movuino/OpenHealthBand/hardware/Shields/MovuinoHealthBandV0.2.7.2-max86141-v0.2.2-panel.brd

## EAGLE design hardware/Shields/MovuinoHealthBandV0.2.7.2-max86141-v0.2.2-panel.brd (2021-08-28)

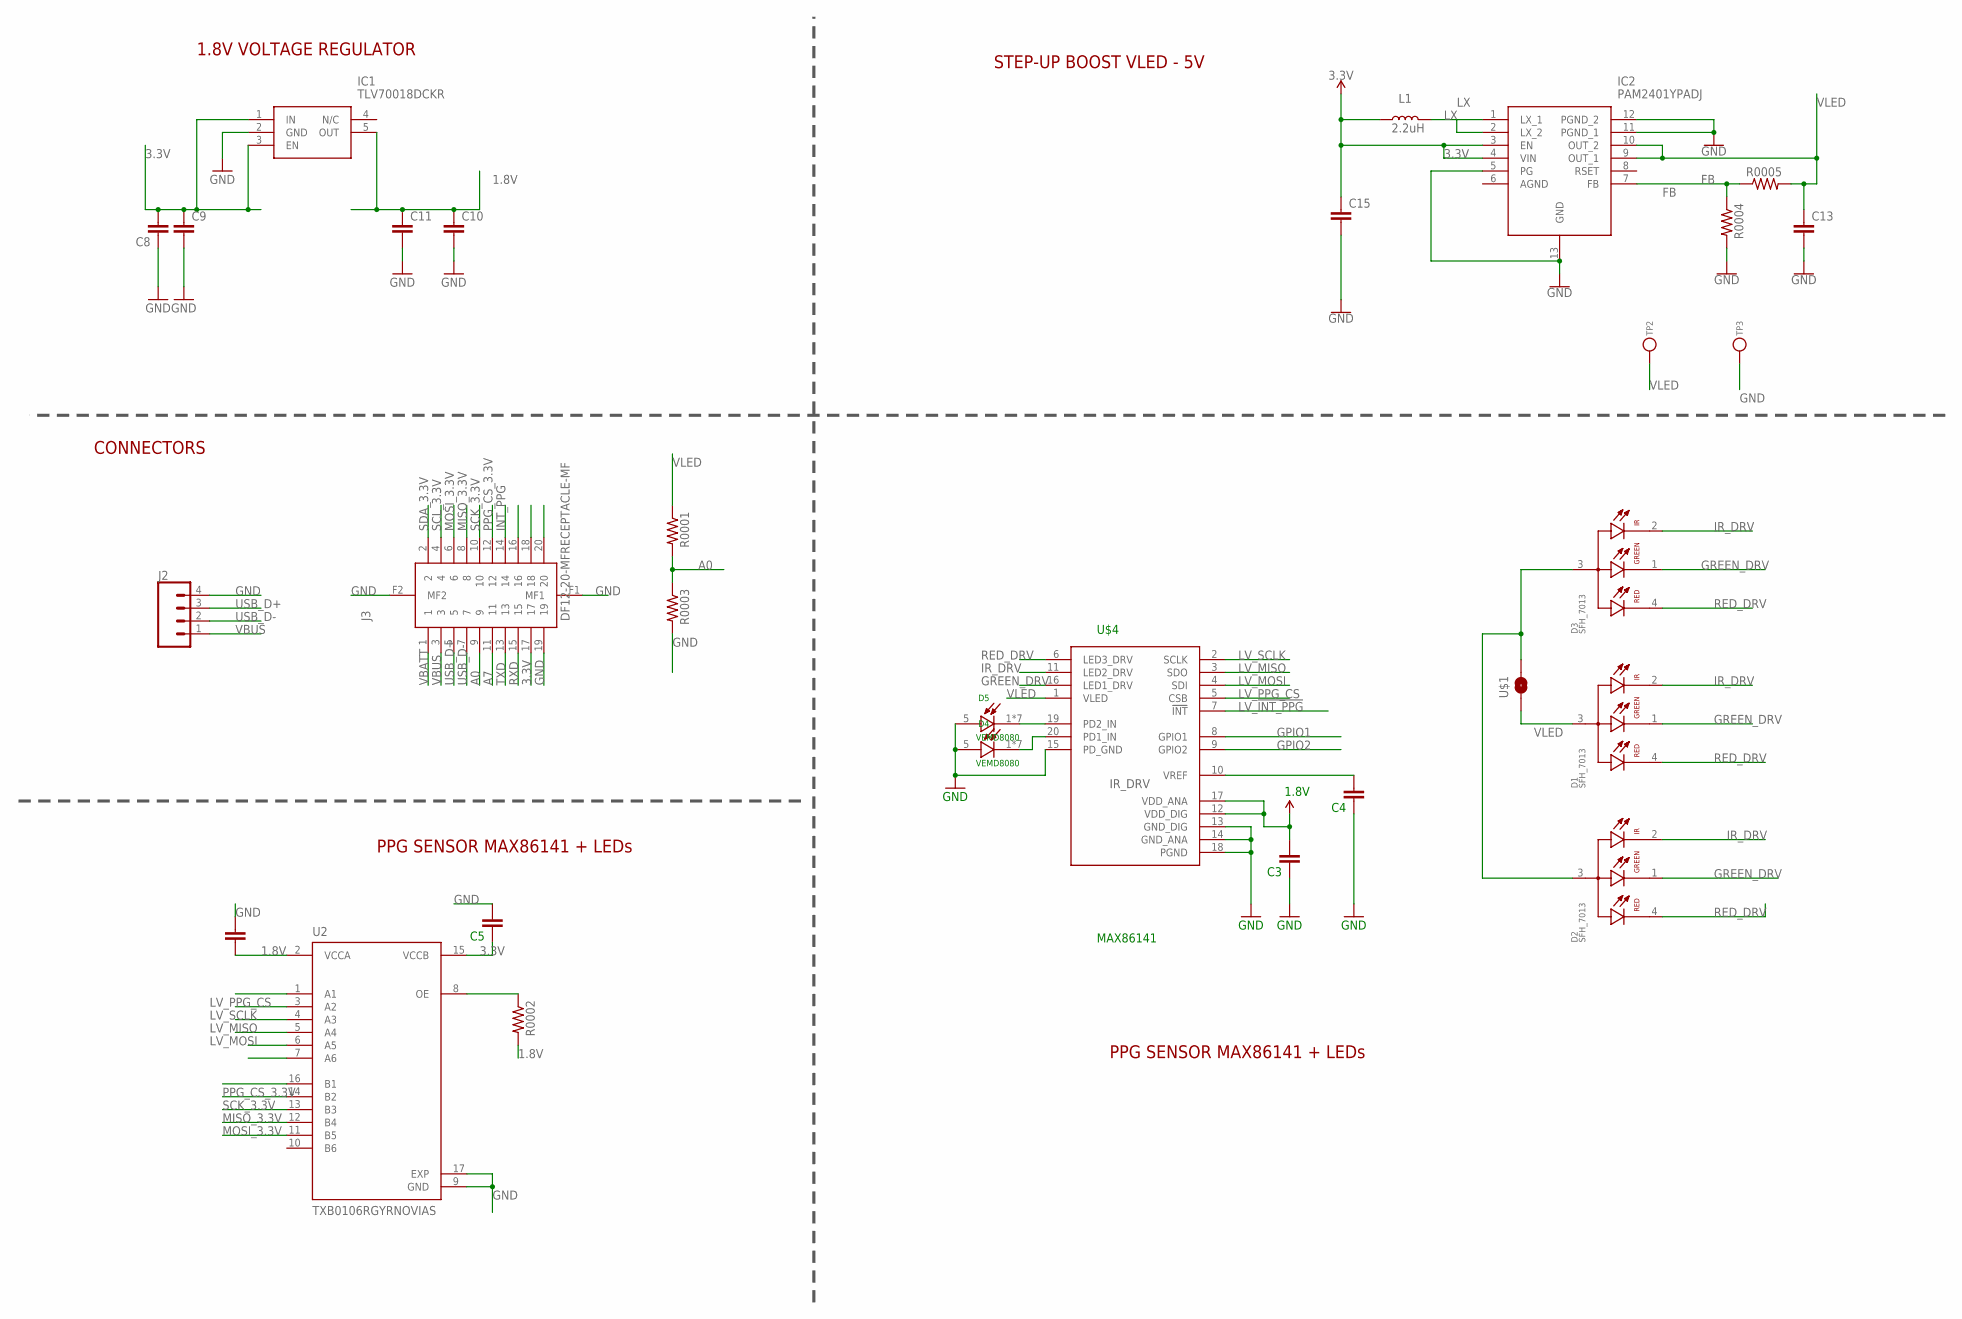
[picture p5: schematic MovuinoHealthBandV0.2.7.2-max86141-v0.2.2-panel.sch]

Parts:
C3: 1uF; 0402-CAP
C4: 10uF; 0402-CAP
C5, C6: 0.1uF; 0402-CAP
C8, C15: 10uF; 0402-CAP-SMALL-TDOCU
C9, C10: 0.1uF; 0402-CAP-SMALL-TDOCU
C11: 4.7uF; 0402-CAP-SMALL-TDOCU
C13: 22uF; 0402-CAP-SMALL-TDOCU
D1, D2, D3: SFH_7013
D4, D5: VEMD8080; XDCR_VEMD8080
IC1: TLV70018DCKR; SOT65P210X110-5N
IC2: PAM2401YPADJ; SON45P295X295X60-13N
J2: CONN_04POGO-2.54; POGO_2.54_X4
J3: DF12-20-MFRECEPTACLE-MF; DF12-20-DS
L1: 2.2uH; INDC2016X100N
R0001, R0002, R0003, R0004: 100K; 0402-RES
R0005: 750K; 0402-RES
TP2, TP3: TESTPOINT1MM-ROUND-CREAM; TESTPOINT_ROUND_1MM-CREAM
U2: TXB0106RGYRNOVIAS; QFN50P400X350X100-17N-2
U$1: 0402-JUMPER
U$4: MAX86141; 20_PIN_WLP

Connections:
1.8V: C3.2, C6.1, C10.1, C11.1, IC1.5 (OUT), R0002.2, U2.2 (VCCA), U$4.12 (VDD_DIG), U$4.17 (VDD_ANA)
3.3V: C5.1, C8.2, C9.1, C15.1, IC1.1 (IN), IC1.3 (EN), IC2.3 (EN), IC2.4 (VIN), J3.17, L1.1, U2.15 (VCCB)
A0: J3.9, R0001.2, R0003.1
A7: J3.11
FB: IC2.7 (FB), R0004.1, R0005.1
GND: C3.1, C4.1, C5.2, C6.2, C8.1, C9.2, C10.2, C11.2, C13.2, C15.2, D4.5 (A), D5.5 (A), IC1.2 (GND), IC2.5 (PG), IC2.11 (PGND_1), IC2.12 (PGND_2), IC2.13 (GND), J2.4, J3.19, J3.F1 (MF1), J3.F2 (MF2), R0003.2, R0004.2, TP3.P$1, U2.9 (GND), U2.17 (EXP), U$4.13 (GND_DIG), U$4.14 (GND_ANA), U$4.15 (PD_GND), U$4.18 (PGND)
GPIO1: U$4.8 (GPIO1)
GPIO2: U$4.9 (GPIO2)
GREEN_DRV: D1.1 (CATHODE_EMITTER_2), D2.1 (CATHODE_EMITTER_2), D3.1 (CATHODE_EMITTER_2), U$4.16 (LED1_DRV)
INT_PPG: J3.14
IR_DRV: D1.2 (CATHODE_EMITTER_3), D2.2 (CATHODE_EMITTER_3), D3.2 (CATHODE_EMITTER_3), U$4.11 (LED2_DRV)
LV_!INT_PPG!: U$4.7 (!INT!)
LV_MISO: U2.5 (A4), U$4.3 (SDO)
LV_MOSI: U2.6 (A5), U$4.4 (SDI)
LV_PPG_CS: U2.3 (A2), U$4.5 (CSB)
LV_SCLK: U2.4 (A3), U$4.2 (SCLK)
LX: IC2.1 (LX_1), IC2.2 (LX_2), L1.2
MISO_3.3V: J3.8, U2.12 (B4)
MOSI_3.3V: J3.6, U2.11 (B5)
unnamed: R0002.1, U2.8 (OE)
unnamed: C4.2, U$4.10 (VREF)
unnamed: D5.1 (C), D5.2 (C), D5.3 (C), D5.4 (C), D5.6 (C), D5.7 (C), D5.8 (C), U$4.19 (PD2_IN)
unnamed: D4.1 (C), D4.2 (C), D4.3 (C), D4.4 (C), D4.6 (C), D4.7 (C), D4.8 (C), U$4.20 (PD1_IN)
unnamed: D2.3 (ANODE_EMITTER_1/2/3), D3.3 (ANODE_EMITTER_1/2/3), U$1.2
PPG_CS_3.3V: J3.12, U2.14 (B2)
RED_DRV: D1.4 (CATHODE_EMITTER_1), D2.4 (CATHODE_EMITTER_1), D3.4 (CATHODE_EMITTER_1), U$4.6 (LED3_DRV)
RXD: J3.15
SCK_3.3V: J3.10, U2.13 (B3)
SCL_3.3V: J3.4
SDA_3.3V: J3.2
TXD: J3.13
USB_D+: J2.3, J3.5
USB_D-: J2.2, J3.7
VBATT: J3.1
VBUS: J2.1, J3.3
VLED: C13.1, D1.3 (ANODE_EMITTER_1/2/3), IC2.9 (OUT_1), IC2.10 (OUT_2), R0001.1, R0005.2, TP2.P$1, U$1.1, U$4.1 (VLED)

Notes on the sheet:
PPG SENSOR MAX86141 + LEDs
STEP-UP BOOST VLED - 5V
1.8V VOLTAGE REGULATOR
CONNECTORS

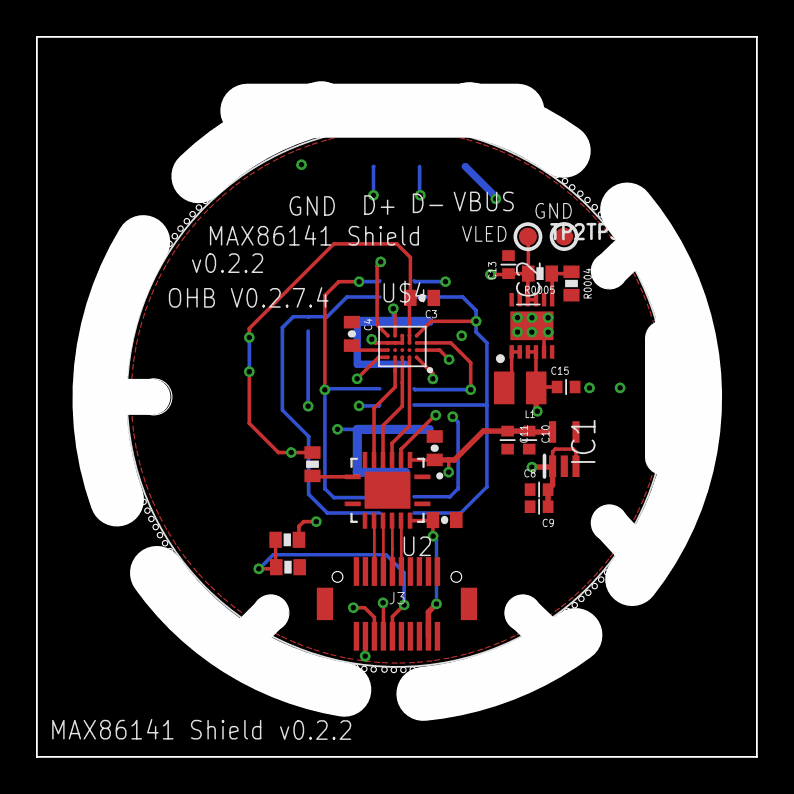
[picture p6: board MovuinoHealthBandV0.2.7.2-max86141-v0.2.2-panel.brd from above]

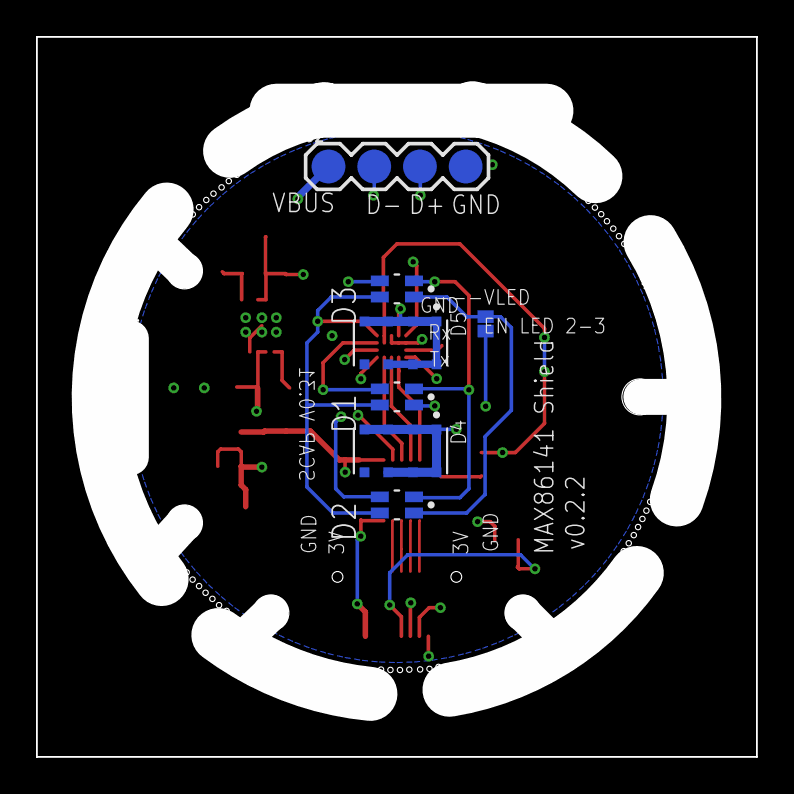
[picture p7: board MovuinoHealthBandV0.2.7.2-max86141-v0.2.2-panel.brd from below]

Board: 4 copper layers, 40.0 x 40.0 mm, 30 parts (7 on the bottom side), 26 nets.
