movuino/OpenHealthBand/hardware/PPGShieldSmall-V0.2-EC.brd

## EAGLE design hardware/PPGShieldSmall-V0.2-EC.brd (2020-03-24)

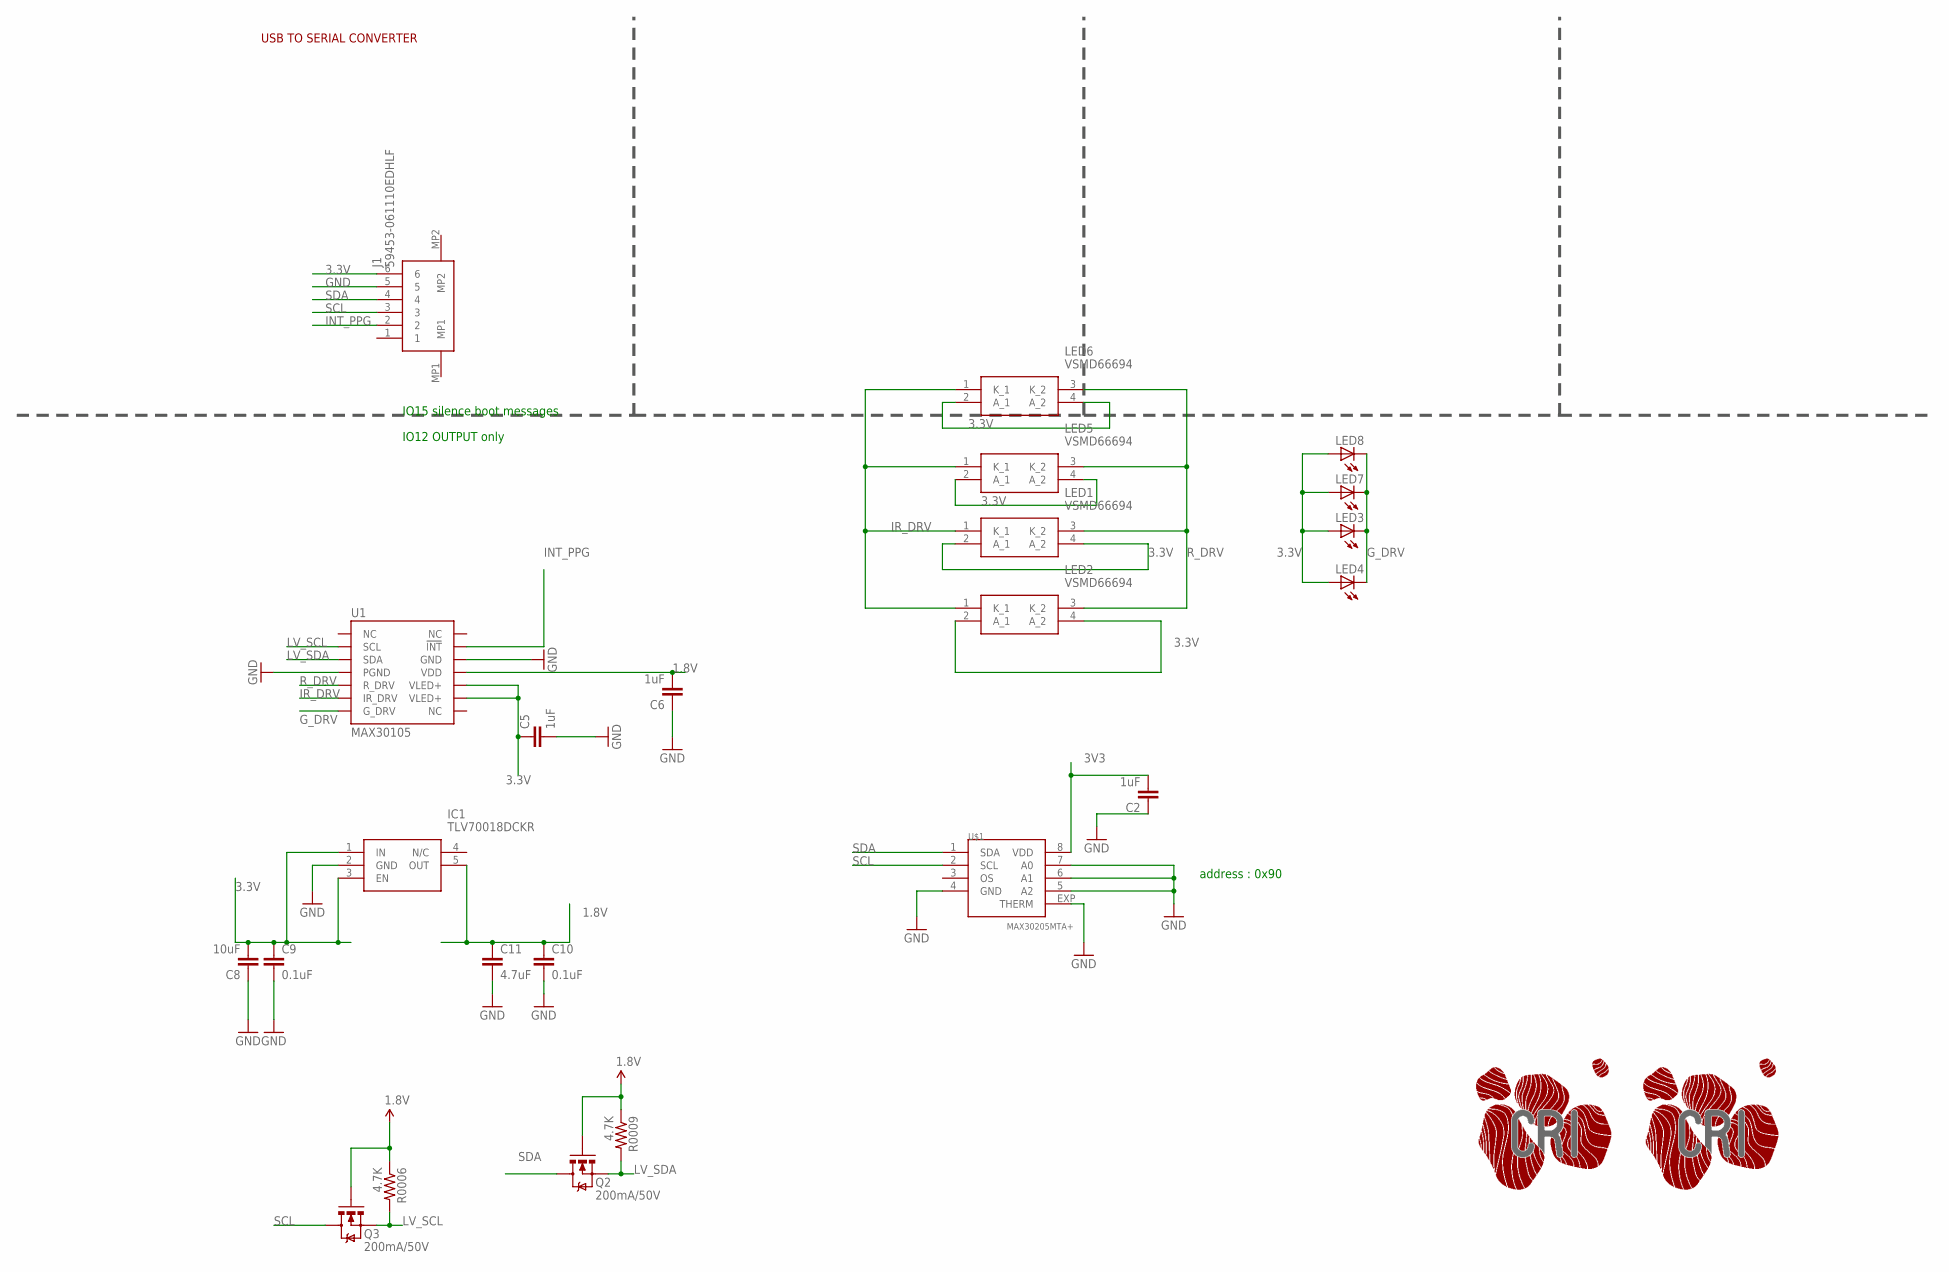
[picture p8: schematic PPGShieldSmall-V0.2-EC.sch]

Parts:
C2, C5, C6: 1uF; 0402-CAP
C8: 10uF; 0402-RES
C9, C10: 0.1uF; 0402-CAP
C11: 4.7uF; 0402-CAP
IC1: TLV70018DCKR; SOT65P210X110-5N
J1: 59453-061110EDHLF; 59453061110EDHLF
LED1, LED2, LED5, LED6: VSMD66694
LED3, LED4, LED7, LED8: LED0603; LED-0603
Q2, Q3: 200mA/50V; SOT23-3
R0006, R0009: 4.7K; 0402-RES
U1: MAX30105; OLGA-14
U$1: MAX30205MTA+; TDFN-08
U$3, U$4: LOGO-CRI-NEW-110MM-BOTTOM-SILK; LOGO_CRI-NEW-BMP10MM-BOTTOM

Connections:
1.8V: C6.2, C10.1, C11.1, IC1.5 (OUT), Q2.1 (G), Q3.1 (G), R0006.1, R0009.1, U1.11 (VDD)
3.3V: C5.1, C8.2, C9.1, IC1.1 (IN), IC1.3 (EN), J1.6, LED1.2 (A_1), LED1.4 (A_2), LED2.2 (A_1), LED2.4 (A_2), LED3.A, LED4.A, LED5.2 (A_1), LED5.4 (A_2), LED6.2 (A_1), LED6.4 (A_2), LED7.A, LED8.A, U1.9 (VLED+), U1.10 (VLED+)
3V3: C2.2, U$1.8 (VDD)
GND: C2.1, C5.2, C6.1, C8.1, C9.2, C10.2, C11.2, IC1.2 (GND), J1.5, U1.4 (PGND), U1.12 (GND), U$1.4 (GND), U$1.5 (A2), U$1.6 (A1), U$1.7 (A0), U$1.EXP (THERM)
G_DRV: LED3.C, LED4.C, LED7.C, LED8.C, U1.7 (G_DRV)
INT_PPG: J1.2, U1.13 (!INT)
IR_DRV: LED1.1 (K_1), LED2.1 (K_1), LED5.1 (K_1), LED6.1 (K_1), U1.6 (IR_DRV)
LV_SCL: Q3.2 (S), R0006.2, U1.2 (SCL)
LV_SDA: Q2.2 (S), R0009.2, U1.3 (SDA)
R_DRV: LED1.3 (K_2), LED2.3 (K_2), LED5.3 (K_2), LED6.3 (K_2), U1.5 (R_DRV)
SCL: J1.3, Q3.3 (D), U$1.2 (SCL)
SDA: J1.4, Q2.3 (D), U$1.1 (SDA)

Notes on the sheet:
USB TO SERIAL CONVERTER
IO12 OUTPUT only
IO15 silence boot messages
address : 0x90

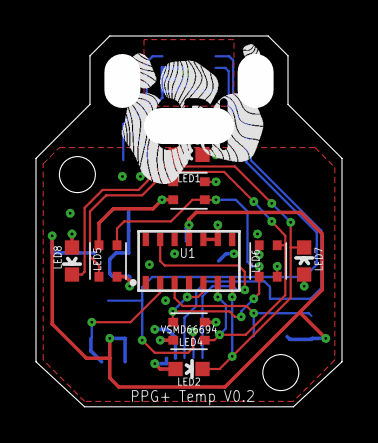
[picture p9: board PPGShieldSmall-V0.2-EC.brd from above]

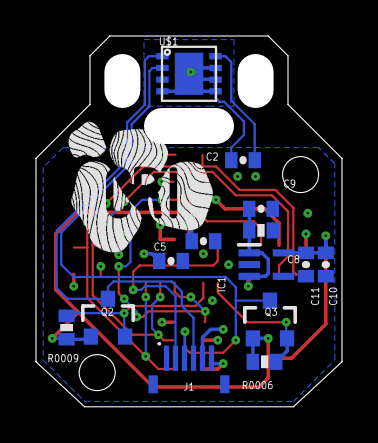
[picture p10: board PPGShieldSmall-V0.2-EC.brd from below]

Board: 4 copper layers, 17.0 x 20.6 mm, 25 parts (15 on the bottom side), 12 nets.
