movuino/OpenHealthBand/hardware/MovuinoHealthBandV0.2.7.4-2.brd

## EAGLE design hardware/MovuinoHealthBandV0.2.7.4-2.brd (2021-08-31)

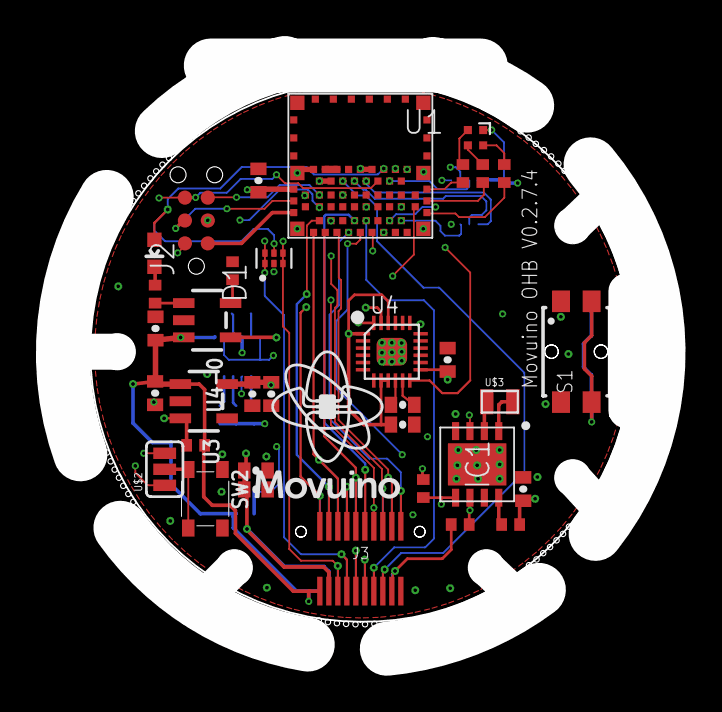
[picture p11: board MovuinoHealthBandV0.2.7.4-2.brd from above]

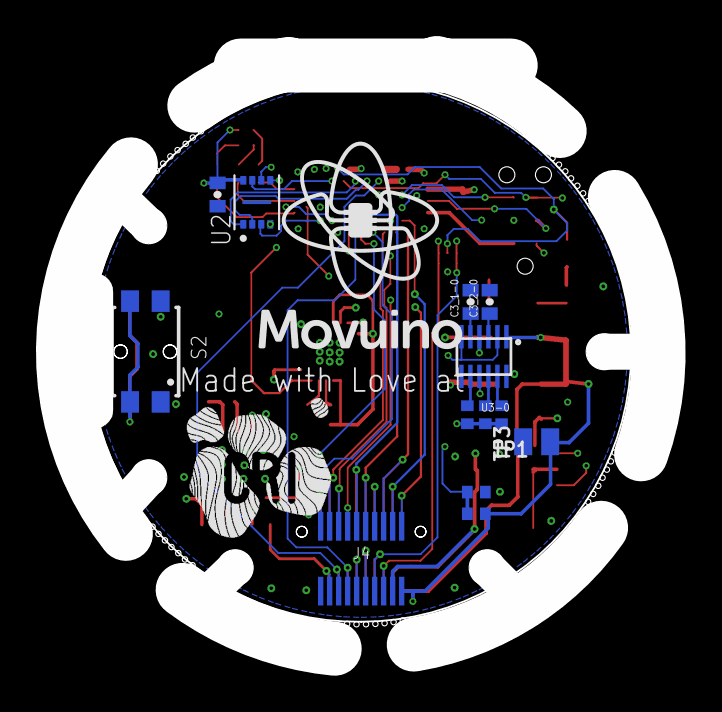
[picture p12: board MovuinoHealthBandV0.2.7.4-2.brd from below]

Board: 4 copper layers, 29.5 x 30.0 mm, 51 parts (14 on the bottom side), 55 nets.

Parts:
C2_1, C2_2, C2_4, C4_1, C6_5, C8_1: 10uF; 0402-CAP
C2_3, C6_1, C8_6, C8_7: 0.1uF; 0402-CAP
C2_5, C3_2-0: 1uF; 0402-CAP
C3_1-0: 470nF; 0402-CAP
C8_5: 0.01uF; 0402-CAP
D1: PRTR5V0U2X,215PRTR5V0U2F; SOT-886
IC1: PCF8523TK_1,118; SON80P400X400X100-9N
J2: TC2030-MCP-NL
J3: DF12-20RECEPTACLE_NO-MF; DF12-20-DS-NO_MF
J4: DF12-20HEADER-5MM_NO-MF; DF12-20-DP-NL-(5.0)
LED4_1-0: Power; LED-0603
R0001, R2_3: 100kR; R0402-SMALL-TDOCU
R0002, R4_2-0: 120R; R0402-SMALL-TDOCU
R0003, R0004: 68; R0402-SMALL-TDOCU
R4_1-0: 5KR; R0402-SMALL-TDOCU
R0005: 100KR; R0402-SMALL-TDOCU
R0006, R0007, R0008, R0009, R0010: 10kR; R0402-SMALL-TDOCU
R0011: 1kR; R0402-SMALL-TDOCU
S1, S2: 4363X10458XX
SW2: BTN_KMT0
TP1, TP3: PAD-1X1.5_NOSILK
U1: ISP1807-LRISP1807-LR_ISP1807-LR; ISP1807-LR
U2: GD25Q16CEIGR; USON8-2X3
U3: AP2112K-3.3TRG13.3V; SOT23-5
U3-0: STM6601; TDFN12
U4: LEAD-QFN24-OLD
U4-0: MCP73831; SOT23-5
U$2: 0402-JUMPER3; SJ_3
U$3: 32.768khz; CRYSTAL-SMD-2X1.2-ABS06
U$5: LRTB_R48G
U$7: LOGO_MOVUINOTOP; LOGO_MOVUINO_BMP_10MM
U$8: LOGO_MOVUINOBOTTOM_11MM; LOGO_MOVUINO_BMP_11MM-BOTTOM
U$9: LOGO-CRI-NEW-110MM-BOTTOM-SILK; LOGO_CRI-NEW-BMP10MM-BOTTOM

Connections:
3.3V: C2_2.1, C2_3.1, C6_1.1, C6_5.2, C8_1.1, C8_5.1, C8_6.1, J2.2, J3.17, J4.3, R0006.2, R0007.2, R0008.2, R0009.2, R0010.2, R0011.1, U1.26, U2.8, U3.5, U3-0.4, U4.1, U4.8, U4.9, U4.13, U4.22, U$5.1
!INT!: R0007.1, U3-0.11
!PB!: S1.2, S1.4, S2.2, S2.4, U3-0.2, U3-0.6
!PB!_OUT: R0006.1, U3-0.8
A0: J3.9, J4.11, U1.42
A2: J3.16, J4.6, U1.35
A3: J3.18, J4.4, U1.36
A5: J3.20, J4.2, U1.38
A7: J3.11, J4.9, U1.44
B: R0004.2, U$5.4
BATT_MONITOR: R0001.1, R0005.2, U1.40
BLUE_LED: R0004.1, U1.6
CSRD: C3_1-0.1, U3-0.5
CS_3.3V: J3.12, J4.10, U1.39
DFU: U1.49, U$2.3
EN: R2_3.1, U3.3, U3-0.9
G: R0003.2, U$5.3
GND: C2_1.2, C2_2.2, C2_3.2, C2_4.2, C2_5.2, C3_1-0.2, C3_2-0.2, C4_1.1, C6_1.2, C6_5.1, C8_1.2, C8_5.2, C8_6.2, C8_7.2, D1.2, IC1.4, IC1.9, J2.3, J3.19, J4.1, R4_1-0.1, R0005.1, S1.1, S1.3, S2.1, S2.3, SW2.A, SW2.A', TP3.P$1, U1.1, U1.7, U1.14, U1.16, U1.18, U1.21, U1.23, U1.24, U1.25, U1.31, U2.4, U3.2, U3-0.12, U4.11, U4.18, U4.20, U4.25, U4-0.2
GREEN_LED: R0003.1, U1.4
INT_MPU: U1.59, U4.12
INT_PPG: J3.14, J4.8, U1.53
MISO_3.3V: J3.8, J4.14, U1.56
MOSI_3.3V: J3.6, J4.16, U1.32
unnamed: R4_2-0.1, U4-0.1
unnamed: IC1.2, U$3.P$1
unnamed: U1.20, U1.22
unnamed: IC1.1, U$3.P$2
unnamed: R0008.1, U3-0.10
unnamed: LED4_1-0.C, R4_2-0.2
unnamed: R4_1-0.2, U4-0.5
unnamed: IC1.8, R0011.2
unnamed: C8_7.1, U4.10
QSPI_CS: U1.15, U2.1
QSPI_DATA0: U1.27, U2.5
QSPI_DATA1: U1.17, U2.2
QSPI_DATA2: U1.47, U2.3
QSPI_DATA3: U1.11, U2.7
QSPI_SCK: U1.45, U2.6
R: R0002.2, U$5.2
RED_LED: R0002.1, U1.2
RESET: J2.6, U1.13, U$2.1
RXD: J3.15, J4.5, U1.19
SCK_3.3V: J3.10, J4.12, U1.34
SCL_3.3V: IC1.6, J3.4, J4.18, R0010.1, U1.33, U4.23
SDA_3.3V: IC1.5, J3.2, J4.20, R0009.1, U1.3, U4.24
SWDCLK: J2.1, U1.30
SWDIO: J2.4, U1.28
SWITCH: SW2.B, SW2.B', U$2.2
SWO: J2.5, U1.57
TXD: J3.13, J4.7, U1.41
USB_D+: D1.3, D1.4, J3.5, J4.15, U1.8
USB_D-: D1.1, D1.6, J3.7, J4.13, U1.10
VBATT: C2_1.1, C4_1.2, IC1.3, J3.1, J4.19, R0001.2, R2_3.2, TP1.P$1, U3.1, U3-0.1, U4-0.3
VBUS: C2_4.1, C2_5.1, D1.5, J3.3, J4.17, LED4_1-0.A, U1.12, U4-0.4
VREF: C3_2-0.1, U3-0.3
