movuino/OpenHealthBand/hardware/Shields/MovuinoHealthBandV0.2.7.4-carrierUSB-v0.2.brd

## EAGLE design hardware/Shields/MovuinoHealthBandV0.2.7.4-carrierUSB-v0.2.brd (2021-08-28)

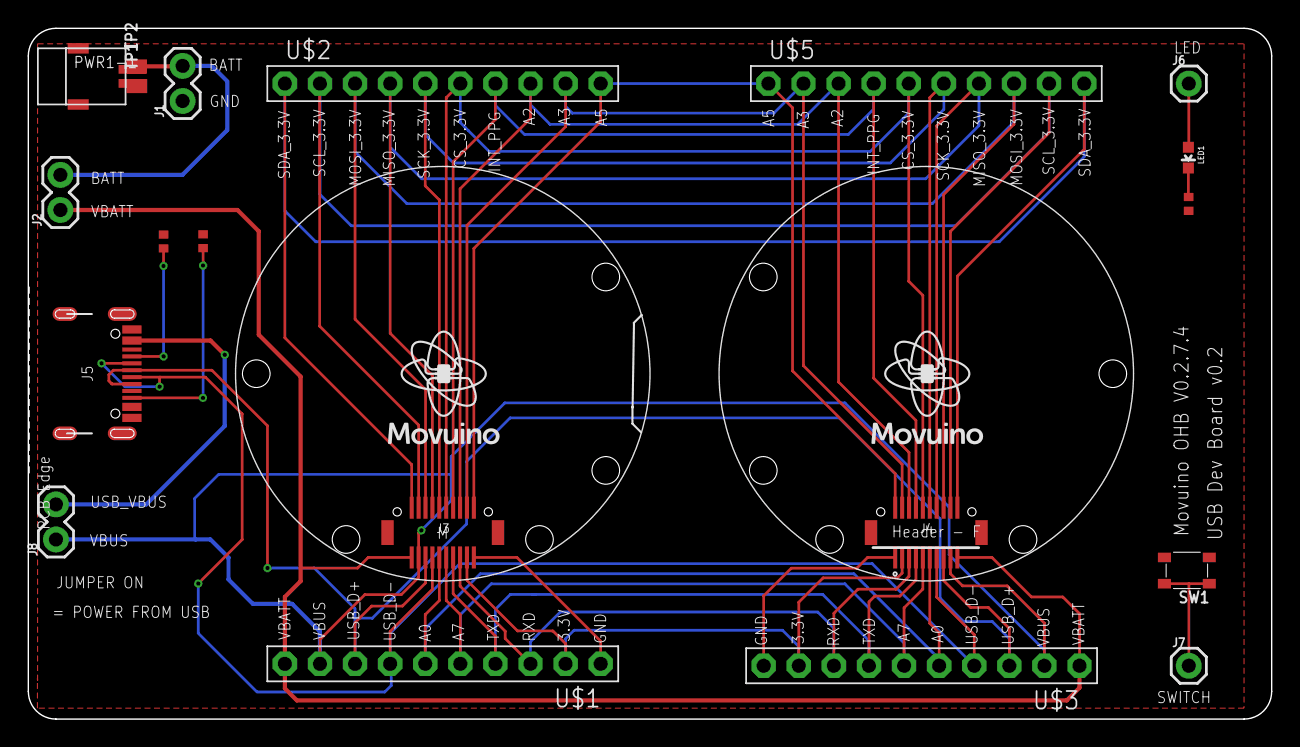
[picture p13: board MovuinoHealthBandV0.2.7.4-carrierUSB-v0.2.brd from above]

Board: 2 copper layers, 90.0 x 50.0 mm, 23 parts (0 on the bottom side), 27 nets.

Parts:
J1, J2, J8: 1X02
J3: DF12-20-MFRECEPTACLE-MF; DF12-20-DS
J4: DF12-20-MFHEADER-5MM-LEGS-BOSS; DF12(5.0)-20-DP
J5: USB-C-16P
J6, J7: 1X01
LED1: LED-0603
PWR1-1: PWR2P_1.0
R2_1: 120; R0402-SMALL-TDOCU
R2_3, R2_4: 5.1K; R0402-SMALL-TDOCU
SW1: BTN_KMT0
TP1, TP2: PAD-1X1.5_NOSILK
U$1, U$2, U$3, U$5: PINHD-1X10; 1X10-BIG
U$7, U$8: LOGO_MOVUINOTOP; LOGO_MOVUINO_BMP_10MM
U$9: LOGO-CRI-NEW-110MM-BOTTOM-SILK; LOGO_CRI-NEW-BMP10MM-BOTTOM

Connections:
3.3V: J3.17, J4.3, U$1.2, U$3.9
A0: J3.9, J4.11, U$1.6, U$3.5
A2: J3.16, J4.6, U$2.8, U$5.3
A3: J3.18, J4.4, U$2.9, U$5.2
A5: J3.20, J4.2, U$2.10, U$5.1
A7: J3.11, J4.9, U$1.5, U$3.6
BATT: J1.2, J2.2, PWR1-1.+, TP2.P$1
CS_3.3V: J3.12, J4.10, U$2.6, U$5.5
GND: J1.1, J3.19, J3.F1, J3.F2, J4.1, J4.F1, J4.F2, J5.A1B12, J5.SHLD1, J5.SHLD2, J5.SHLD3, J5.SHLD4, J5.SHLD5, J5.SHLD6, J5.SHLD7, J5.SHLD8, PWR1-1.-, R2_1.1, R2_3.1, R2_4.1, SW1.B, SW1.B', TP1.P$1, U$1.1, U$3.10
INT_PPG: J3.14, J4.8, U$2.7, U$5.4
MISO_3.3V: J3.8, J4.14, U$2.4, U$5.7
MOSI_3.3V: J3.6, J4.16, U$2.3, U$5.8
unnamed: LED1.C, R2_1.2
unnamed: J6.1, LED1.A
unnamed: J7.1, SW1.A, SW1.A'
unnamed: J5.A5, R2_4.2
unnamed: J5.B5, R2_3.2
RXD: J3.15, J4.5, U$1.3, U$3.8
SCK_3.3V: J3.10, J4.12, U$2.5, U$5.6
SCL_3.3V: J3.4, J4.18, U$2.2, U$5.9
SDA_3.3V: J3.2, J4.20, U$2.1, U$5.10
TXD: J3.13, J4.7, U$1.4, U$3.7
USB_D+: J3.5, J4.15, J5.A6, J5.B6, U$1.8, U$3.3
USB_D-: J3.7, J4.13, J5.A7, J5.B7, U$1.7, U$3.4
USB_VBUS: J5.A4B9, J8.2
VBATT: J2.1, J3.1, J4.19, U$1.10, U$3.1
VBUS: J3.3, J4.17, J8.1, U$1.9, U$3.2
