movuino/OpenHealthBand/hardware/MovuinoHealthBandV0.2.5-panel.brd

## EAGLE design hardware/MovuinoHealthBandV0.2.5-panel.brd (2020-03-24)

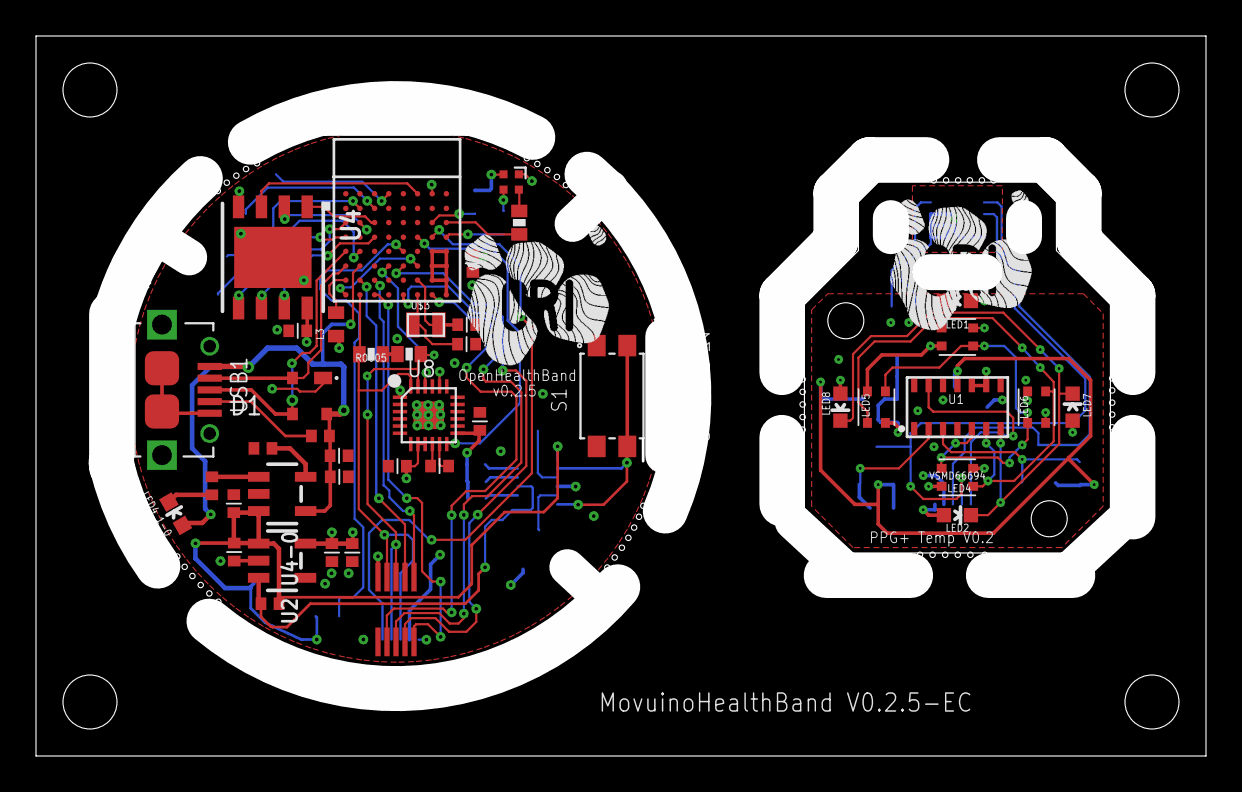
[picture p14: board MovuinoHealthBandV0.2.5-panel.brd from above]

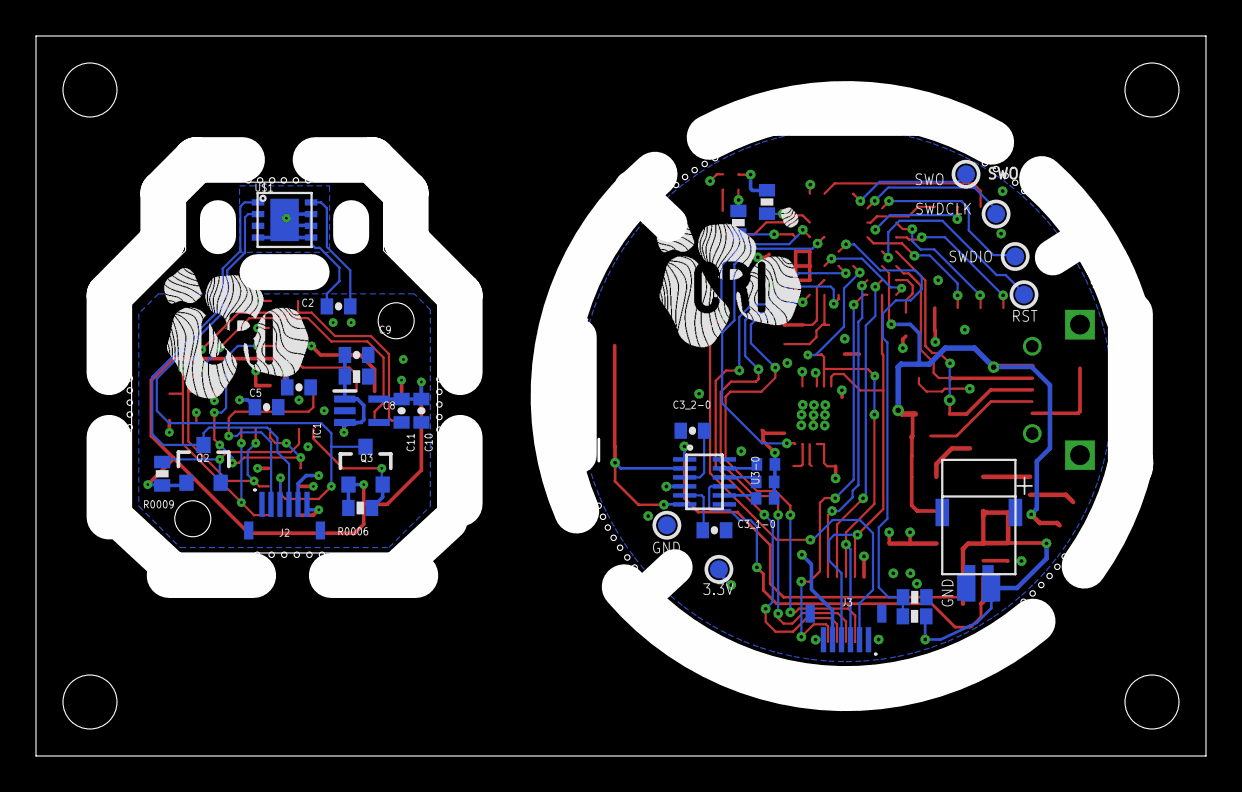
[picture p15: board MovuinoHealthBandV0.2.5-panel.brd from below]

Board: 4 copper layers, 65.0 x 40.0 mm, 80 parts (36 on the bottom side), 61 nets.

Parts:
3.3V: TESTPOINT_ROUND_1MM
C2, C3_2-0, C5, C6: 1uF; 0402-CAP
C2_1, C2_2, C2_4, C4_1, C6_5: 10uF; 0402-CAP-SMALL-TDOCU
C2_3: 1uF; 0402-CAP-SMALL-TDOCU
C3_1-0: 470nF; 0402-CAP
C6_1, C6_2, C8_1, C8_2: 0.1uF; 0402-CAP-SMALL-TDOCU
C6_3, C6_4: 12pF; 0402-CAP-SMALL-TDOCU
C8: 10uF; 0402-RES
C8_3: 0.01uF; 0402-CAP-SMALL-TDOCU
C9, C10: 0.1uF; 0402-CAP
C11: 4.7uF; 0402-CAP
D1: PRTR5V0U2X,215; SOT143B
GND2: TESTPOINT_ROUND_1MM
IC1: TLV70018DCKR; SOT65P210X110-5N
J1: DF12-10-F; DF12-10-DP
J2, J3: 59453-061110EDHLF; 59453061110EDHLF
L3: 10uH; C0402
LED1, LED2, LED5, LED6: VSMD66694
LED3, LED4, LED7, LED8: LED-0603
LED4_1-0: Power; LED-0603
PWR1: PWR2P_1.0
Q2, Q3: 200mA/50V; SOT23-3
R0001, R0002, R0003, R0004, R0005: 10K; 0402-RES
R2_1, R2_2: 100K; R0402-SMALL-TDOCU
R3_2-0, R3_3-0, R3_10: 10KR; R0402-SMALL-TDOCU
R4-1-0: 5KR; R0402-SMALL-TDOCU
R4_2, R4_3: 100kR; 0402-RES
R4_2-0: 120R; R0402-SMALL-TDOCU
R0006, R0009: 4.7K; 0402-RES
RESET: TESTPOINT_ROUND_1MM
S1: 434331045822
SWCLK: TESTPOINT_ROUND_1MM
SWIO: TESTPOINT_ROUND_1MM
SWO: TESTPOINT_ROUND_1MM
TP3, TP4: PAD-1X1.5_NOSILK
U1: MAX30105; OLGA-14
U2: AP2112-3.3; SOT23-5
U3: BC840
U3-0: STM6601; TDFN12
U4: W25Q16BVZP; WSON8
U4-0: MCP73831; SOT23-5
U8: LEAD-QFN24
U$1: MAX30205MTA+; TDFN-08
U$2, U$4, U$5, U$6: LOGO-CRI-NEW-110MM-BOTTOM-SILK; LOGO_CRI-NEW-BMP10MM-BOTTOM
U$3: 32.768khz; CRYSTAL-SMD-2X1.2-ABS06
U$24: LRTB_R48G
USB1: MICRO-USB5+6P-SMD-0.65-AB-TB

Connections:
1.8V: C6.2, C10.1, C11.1, IC1.5, Q2.1, Q3.1, R0006.1, R0009.1, U1.11
3.3V: 3.3V.P$1, C2_2.1, C2_3.1, C6_1.1, C6_5.2, C8_1.1, C8_3.1, J1.2, J3.6, L3.1, R3_2-0.2, R3_3-0.2, R3_10.2, U2.5, U3.A7, U3.F5, U3-0.4, U4.8, U8.1, U8.8, U8.9, U8.13, U8.22, U$24.1
3.3V1: C5.1, C8.2, C9.1, IC1.1, IC1.3, J2.6, LED1.2, LED1.4, LED2.2, LED2.4, LED3.A, LED4.A, LED5.2, LED5.4, LED6.2, LED6.4, LED7.A, LED8.A, U1.9, U1.10
3V: R0004.2, R0005.2
3V3: C2.2, U$1.8
!INT!: R3_2-0.1, U3-0.11
!PB!: S1.2, S1.4, U3-0.2, U3-0.6
!PB!_OUT: R3_3-0.1, U3-0.8
A0: J1.5, U3.E7
A1: J1.3, U3.G7
A7: J1.7, U3.E5
B: R0003.2, U$24.4
BATT_MONITOR: R4_2.2, R4_3.1, U3.E4
BLUE_LED: R0003.1, U3.G2
CSRD: C3_1-0.1, U3-0.5
D6: J1.8, U3.B6
D12: J1.9, U3.C7
D13: J1.10, U3.C6
EN: R2_2.1, U2.3, U3-0.9
G: R0002.2, U$24.3
GND: C2_1.2, C2_2.2, C2_3.2, C2_4.2, C3_1-0.2, C3_2-0.2, C4_1.1, C6_1.2, C6_2.2, C6_3.2, C6_4.2, C6_5.1, C8_1.2, C8_2.2, C8_3.2, D1.1, GND2.P$1, J1.1, J3.5, PWR1.-, R4-1-0.2, R4_3.2, S1.1, S1.3, TP3.P$1, U2.2, U3.G0, U3.G4, U3.G5, U3.G6, U3.H4, U3.H5, U3.H6, U3.H7, U3-0.12, U4.4, U4.9, U4-0.2, U8.11, U8.18, U8.20, U8.25, USB1.5, USB1.P1, USB1.P2, USB1.P5, USB1.P6, USB1.P$3, USB1.P$4
GND1: C2.1, C5.2, C6.1, C8.1, C9.2, C10.2, C11.2, IC1.2, J2.5, U1.4, U1.12, U$1.4, U$1.5, U$1.6, U$1.7, U$1.EXP
GREEN_LED: R0002.1, U3.H3
G_DRV: LED3.C, LED4.C, LED7.C, LED8.C, U1.7
INT_MPU: U3.F3, U8.12
INT_PPG: J3.2, U3.G3
INT_PPG1: J2.2, U1.13
IR_DRV: LED1.1, LED2.1, LED5.1, LED6.1, U1.6
LV_SCL: Q3.2, R0006.2, U1.2
LV_SDA: Q2.2, R0009.2, U1.3
unnamed: R4_2-0.2, U4-0.1
unnamed: R2_1.2, USB1.4
unnamed: C6_3.1, U3.F6, U$3.P$2
unnamed: C6_4.1, U3.F7, U$3.P$1
unnamed: R3_10.1, U3-0.10
unnamed: LED4_1-0.C, R4_2-0.1
unnamed: R4-1-0.1, U4-0.5
unnamed: L3.2, U3.A6
unnamed: C8_2.1, U8.10
QSPI_CS: U3.C2, U4.1
QSPI_DATA0: U3.A3, U4.5
QSPI_DATA1: U3.B2, U4.2
QSPI_DATA2: U3.F0, U4.3
QSPI_DATA3: U3.C3, U4.7
QSPI_SCK: U3.A2, U4.6
R: R0001.2, U$24.2
RED_LED: R0001.1, U3.H2
RESET: RESET.P$1, U3.B4
R_DRV: LED1.3, LED2.3, LED5.3, LED6.3, U1.5
SCL: J1.6, J3.3, R0005.1, U3.D5, U8.23
SCL1: J2.3, Q3.3, U$1.2
SDA: J1.4, J3.4, R0004.1, U3.B7, U8.24
SDA1: J2.4, Q2.3, U$1.1
SWDCLK: SWCLK.P$1, U3.C1
SWDIO: SWIO.P$1, U3.B1
SWO: SWO.P$1, U3.D0
USB_D+: D1.3, U3.A4, USB1.3
USB_D-: D1.2, U3.A5, USB1.2
VBATT: C2_1.1, C4_1.2, PWR1.+, R2_2.2, R4_2.1, TP4.P$1, U2.1, U3-0.1, U4-0.3
VBUS: C2_4.1, C6_2.1, D1.4, LED4_1-0.A, R2_1.1, U3.B5, U4-0.4, USB1.1
VREF: C3_2-0.1, U3-0.3
