movuino/OpenHealthBand/OpenHealthBand_v0.2.5/PPG.ino

void setupHRM(void)
{
  // Configure the Heart Rate Monitor service

  // Name                         UUID    Requirement Properties
  // ---------------------------- ------  ----------- ----------
  // Heart Rate Measurement       0x2A37  Mandatory   Notify
  // Body Sensor Location         0x2A38  Optional    Read
  hrms.begin();

  // Note: You must call .begin() on the BLEService before calling .begin() on
  // any characteristic(s) within that service definition.. Calling .begin() on
  // a BLECharacteristic will cause it to be added to the last BLEService that
  // was 'begin()'ed!

  hrmc.setProperties(CHR_PROPS_NOTIFY);
  hrmc.setPermission(SECMODE_OPEN, SECMODE_NO_ACCESS);
  hrmc.setFixedLen(2);
  hrmc.setCccdWriteCallback(cccd_callback);  // Optionally capture CCCD updates
  hrmc.begin();
  uint8_t hrmdata[2] = { 0b00000110, 0x40 }; // Set the characteristic to use 8-bit values, with the sensor connected and detected
  hrmc.write(hrmdata, 2);

  bslc.setProperties(CHR_PROPS_READ);
  bslc.setPermission(SECMODE_OPEN, SECMODE_NO_ACCESS);
  bslc.setFixedLen(1);
  bslc.begin();
  bslc.write8(2);    // Set the characteristic to 'Wrist' (2)
}

void initPPG(){
  // Initialize sensor
  if (!ppgSensor.begin(Wire, I2C_SPEED_FAST)) //Use default I2C port, 400kHz speed
  {
    Serial.println("MAX30105 was not found. Please check wiring/power. ");
    while (1);
  }
}

void setupPPG(){
  ppgSensor.setup(ledBrightness, sampleAverage, ledMode, sampleRate, pulseWidth, adcRange); //Configure sensor with these settings
  
  //Take an average of IR readings at power up
  const byte avgAmount = 64;
  long baseValue = 0;
  for (byte x = 0 ; x < avgAmount ; x++)
  {
    baseValue += ppgSensor.getIR(); //Read the IR value
  }
  baseValue /= avgAmount;

  //Pre-populate the plotter so that the Y scale is close to IR values
  for (int x = 0 ; x < 500 ; x++)
    Serial.println(baseValue);
}

void getPPG(){
  bps = ppgSensor.getIR();
}
