movuino/OpenHealthBand/(commit log)

2020-01-20 Code for BLE characteristics
    Code for Device Information, Battery Level, Heart Rate Measurement and Health Thermometer
2020-03-24 added pcb files
    [MovuinoHealthBandV0.2.4-EC.brd, MovuinoHealthBandV0.2.4-EC.sch, MovuinoHealthBandV0.2.5-panel.brd, PPGShieldSmall-V0.2-EC.brd, PPGShieldSmall-V0.2-EC.sch, PPGShieldSmall-V0.2.1.brd, PPGShieldSmall-V0.2.1.sch]
2021-08-28 added shield PPG MAX86141 v0.2.1 (BSS138 level shifter)
    [MovuinoHealthBandV0.2.7.2-max86141-v0.2.1-panel.brd, MovuinoHealthBandV0.2.7.2-max86141-v0.2.1-panel.sch]
2021-08-28 added v0.2.2 (level convertion IC)
    [MovuinoHealthBandV0.2.7.2-max86141-v0.2.2-panel.brd, MovuinoHealthBandV0.2.7.2-max86141-v0.2.2-panel.sch]
2021-08-28 added carrier USB Dev board
    [MovuinoHealthBandV0.2.7.4-carrierUSB-v0.2.brd]
2021-08-31 update board
    [MovuinoHealthBandV0.2.4-EC.brd, MovuinoHealthBandV0.2.4-EC.sch, MovuinoHealthBandV0.2.7.4-2.brd]
