movuino/OpenHealthBand/(notices)

Notices in the files:
parts and their libraries:
movuino: ©2009 ROFA.cz - modified and updated by Robert Darlington ‹rdarlington@gmail.com›
SparkFun-Connectors: Licensing: Creative Commons ShareAlike 4.0 International - https://creativecommons.org/licenses/by-sa/4.0
Wurth_Elektronik_Electromechanic_Switch_: Copyright: Würth Elektronik
